ITGuyFromIA2/AxxSolder_hw/README.md

# AxxSolder_hw
Hardware repository for AxxSolder  
  
**Find the main AxxSolder repo here: [https://github.com/AxxAxx/AxxSolder](https://github.com/AxxAxx/AxxSolder)**
