ITGuyFromIA2/AxxSolder_hw/bom/BOM_AxxSolder_V2_2.xlsx

AxxSolder V2.2 | Prises as per 2023-10-03 |  | Parts for AxxSolder Station only
 |  |  | Parts for AxxSolder Poratble only
Part | Value | Device | Footprint | # in design | Price / component | Price / unit |  |  | Datasheet | Manufacturer_Part_Number | Mouser Part Number
C1, C6, C12, C14, C19 | 10u | Device:C_Small | Capacitor_SMD:C_0805_2012Metric | 5 | €0.32 | €1.60 | https://www.mouser.se/ProductDetail/Murata-Electronics/GRM21BR6YA106ME43L?qs=K0Sa7bCb58L8Cutg5cHuEA%3D%3D | https://www.mouser.com/ProductDetail/Murata-Electronics/GRM21BR6YA106ME43L?qs=K0Sa7bCb58L8Cutg5cHuEA%3D%3D | ~
C2, C3, C5, C7, C8, C9, C10, C11, C13, C20, C21, C22, C24, C28, C29 | 100n | Device:C_Small | Capacitor_SMD:C_0805_2012Metric | 15 | €0.09 | €1.40 | https://www.mouser.se/ProductDetail/KYOCERA-AVX/KGM21NR71H104KT?qs=Jm2GQyTW%2Fbj%252BykwLLGtT1A%3D%3D | https://www.mouser.com/ProductDetail/KYOCERA-AVX/KGM21NR71H104KT?qs=Jm2GQyTW%2Fbj%252BykwLLGtT1A%3D%3D | ~
C4, C25, C27 | 22u | Device:C_Small | Capacitor_SMD:C_1206_3216Metric | 3 | €0.54 | €1.62 | https://www.mouser.se/ProductDetail/TDK/C2012X6S1C226M125AC?qs=6JAMGB%252BEdkzwYUkuPLa%252B7A%3D%3D | https://www.mouser.com/ProductDetail/TDK/C2012X6S1C226M125AC?qs=6JAMGB%252BEdkzwYUkuPLa%252B7A%3D%3D
C17, C18 | 22u/35V | Device:C_Small | Capacitor_SMD:C_0805_2012Metric | 2 | €0.88 | €1.76 | https://www.mouser.se/ProductDetail/TDK/C3216X5R1V226M160AC?qs=NRhsANhppD8TwN31eZ1xGQ%3D%3D | https://www.mouser.com/ProductDetail/TDK/C3216X5R1V226M160AC?qs=NRhsANhppD8TwN31eZ1xGQ%3D%3D
C15, C16 | 1n | Device:C_Small | Capacitor_SMD:C_0805_2012Metric | 2 | €0.09 | €0.19 | https://www.mouser.se/ProductDetail/KYOCERA-AVX/KGM21NR71H102KT?qs=Jm2GQyTW%2FbjaB2aNl9uKTA%3D%3D | https://www.mouser.com/ProductDetail/KYOCERA-AVX/KGM21NR71H102KT?qs=Jm2GQyTW%2FbjaB2aNl9uKTA%3D%3D | ~
C23 | 330u | EMZR500ARA331MJA0G:EMZR500ARA331MJA0G | EMZR500ARA331MJA0G:CAPAE1030X1050N | 1 | €1.16 | €1.16 | https://www.mouser.se/ProductDetail/Chemi-Con/EMZR500ARA331MJA0G?qs=y6ZabgHbY%252ByH%252BUe1C3ntew%3D%3D | https://www.mouser.com/ProductDetail/Chemi-Con/EMZR500ARA331MJA0G?qs=y6ZabgHbY%252ByH%252BUe1C3ntew%3D%3D | https://ru.mouser.com/datasheet/2/420/United-Chemi-Con-776012.pdf | EMZR500ARA331MJA0G | 661-EMZR500ARA331MJA
C26 | 75p | Device:C_Small | Capacitor_SMD:C_0805_2012Metric | 1 | €0.15 | €0.15 | https://www.mouser.se/ProductDetail/KYOCERA-AVX/08051A750JAT2A?qs=xM%2FcMNU7BsFb8CFBKrIbNg%3D%3D | https://www.mouser.com/ProductDetail/KYOCERA-AVX/08051A750JAT2A?qs=xM%2FcMNU7BsFb8CFBKrIbNg%3D%3D |  | 08051A750JAT2A
D1, D3, D5, D6, D12 | BAT54S | Device:D_Schottky_Dual_Series_AKC | BAT54S,215:SOT95P230X110-3N | 5 | €0.26 | €1.30 | https://www.mouser.se/ProductDetail/Diotec-Semiconductor/BAT54S?qs=OlC7AqGiEDl5%2FwzZD7rGmQ%3D%3D | https://www.mouser.com/ProductDetail/Diotec-Semiconductor/BAT54S?qs=OlC7AqGiEDl5%2FwzZD7rGmQ%3D%3D | ~
D2 | PMEG6020ER | PMEG6020ER_115:PMEG6020ER,115 | PMEG6020ER,115:PMEG6020ER115 | 1 | €0.42 | €0.42 | https://www.mouser.se/ProductDetail/Nexperia/PMEG6020ER115?qs=5DYmZrWuUErk3dU9e9SSpA%3D%3D | https://www.mouser.com/ProductDetail/Nexperia/PMEG6020ER115?qs=5DYmZrWuUErk3dU9e9SSpA%3D%3D | https://assets.nexperia.com/documents/data-sheet/PMEG6020ER.pdf | PMEG6020ER,115 | 771-PMEG6020ER-115
D4 | Waveshare 1.5inch OLED Module | 1_5inch-rgb-oled-module_asm-1110:1_5inch-rgb-oled-module_asm-1110 | 1_5inch-rgb-oled-module_asm-1110:1_5inch-rgb-oled-module_asm-1110 | 1 | €12.90 | €12.90 | https://www.welectron.com/Waveshare-13992-15inch-OLED-Module_1 | https://www.welectron.com/Waveshare-13992-15inch-OLED-Module_1
D7 | PMEG10030ELPX | PMEG10030ELPX:PMEG10030ELPX | PMEG10030ELPX:SODFL4725X110N | 1 | €0.45 | €0.45 | https://www.mouser.se/ProductDetail/Nexperia/PMEG10030ELPX?qs=bel5lzaZNxQd6L7wuvMmFQ%3D%3D | https://www.mouser.com/ProductDetail/Nexperia/PMEG10030ELPX?qs=bel5lzaZNxQd6L7wuvMmFQ%3D%3D | https://assets.nexperia.com/documents/data-sheet/PMEG10030ELP.pdf | PMEG10030ELPX | 771-PMEG10030ELPX
D9 | SMBJ24CA | SMBJ24CA:SMBJ24CA | DIOM5436X261N | 1 | €0.34 | €0.34 | https://www.mouser.se/ProductDetail/Littelfuse/SMBJ24CA?qs=JJML70Qc14u3Wc4gmMep1w%3D%3D | https://www.mouser.com/ProductDetail/Littelfuse/SMBJ24CA?qs=JJML70Qc14u3Wc4gmMep1w%3D%3D | https://www.mouser.se/datasheet/2/240/media-3319099.pdf | SMBJ24CA | 576-SMBJ24CA
F1 | 10A Fuse | Device:Fuse | 3557-2:3557-2 | 1 | €1.10 | €1.10 | https://www.mouser.se/ProductDetail/Keystone-Electronics/3557-2?qs=cxy41lVAGV%2FfbyASjpXK1g%3D%3D | https://www.mouser.com/ProductDetail/Keystone-Electronics/3557-2?qs=cxy41lVAGV%2FfbyASjpXK1g%3D%3D | ~
IC1 | LTC4440AHMS8E-5#PBF | LTC4440AHMS8E-5#PBF:LTC4440AHMS8E-5#PBF | LTC4440AHMS8E-5#PBF:SOP65P490X110-9N | 1 | €5.72 | €5.72 | https://www.mouser.se/ProductDetail/Analog-Devices/LTC4440AHMS8E-5PBF?qs=hVkxg5c3xu86VC%252BBJjm7uA%3D%3D | https://www.mouser.com/ProductDetail/Analog-Devices/LTC4440AHMS8E-5PBF?qs=hVkxg5c3xu86VC%252BBJjm7uA%3D%3D | https://www.arrow.com/en/products/ltc4440ahms8e-5pbf/analog-devices | LTC4440AHMS8E-5#PBF | 584-C4440AHMS8E-5PBF
IC2 | STM32G431KBT6 | STM32G431KBT6:STM32G431KBT6 | STM32G431KBT6:QFP80P900X900X160-32N | 1 | €6.45 | €6.45 | https://www.mouser.se/ProductDetail/STMicroelectronics/STM32G431KBT6?qs=T3oQrply3y8teCTeNAFOLg%3D%3D | https://www.mouser.com/ProductDetail/STMicroelectronics/STM32G431KBT6?qs=T3oQrply3y8teCTeNAFOLg%3D%3D | https://www.st.com/resource/en/datasheet/stm32g431kb.pdf | STM32G431KBT6 | 511-STM32G431KBT6
L1 | SRP7028CC-100M | SRP7028CC-100M:SRP7028CC-100M | INDPM7366X300N | 1 | €0.75 | €0.75 | https://www.mouser.se/ProductDetail/Bourns/SRP7028CC-100M?qs=1Kr7Jg1SGW%252BFrchEKUd2WQ%3D%3D | https://www.mouser.com/ProductDetail/Bourns/SRP7028CC-100M?qs=1Kr7Jg1SGW%252BFrchEKUd2WQ%3D%3D | https://www.bourns.com/docs/Product-Datasheets/SRP7028CC.pdf | SRP7028CC-100M | 652-SRP7028CC-100M
IC3 | TMP236AQDBZRQ1 | TMP236AQDBZRQ1:TMP236AQDBZRQ1 | TMP236AQDBZRQ1:SOT95P237X112-3N | 1 | €0.55 | €0.55 | https://www.mouser.se/ProductDetail/Texas-Instruments/TMP236AQDBZRQ1?qs=T3oQrply3y83CHFf%2F7t6GQ%3D%3D | https://www.mouser.com/ProductDetail/Texas-Instruments/TMP236AQDBZRQ1?qs=T3oQrply3y83CHFf%2F7t6GQ%3D%3D | https://www.ti.com/lit/gpn/TMP236-Q1 | TMP236AQDBZRQ1 | 595-TMP236AQDBZRQ1
IC4 | OPA2333AIDRBR | OPA2333AIDRBR:OPA2333AIDRBR | OPA2333AIDRBR:SON65P300X300X100-9N-D | 1 | €3.78 | €3.78 | https://www.mouser.se/ProductDetail/Texas-Instruments/OPA2333AIDRBR?qs=pJP364FAHqRpZMi9vrj2VQ%3D%3D | https://www.mouser.com/ProductDetail/Texas-Instruments/OPA2333AIDRBR?qs=pJP364FAHqRpZMi9vrj2VQ%3D%3D | https://www.ti.com/lit/ds/symlink/opa2333.pdf?ts=1606982025063 | OPA2333AIDRBR | 595-OPA2333AIDRBR
J1 | Conn_01x07_Male | Connector:Conn_01x07_Male | 691243310007:691243310007 | 1 | €2.99 | €2.99 | https://www.mouser.se/ProductDetail/Wurth-Elektronik/691243310007?qs=sPbYRqrBIVlY9pfFip%2Fg9g%3D%3D | https://www.mouser.com/ProductDetail/Wurth-Elektronik/691243310007?qs=sPbYRqrBIVlY9pfFip%2Fg9g%3D%3D | ~
J4 | Conn_01x07_Male | Connector:Conn_01x07_Male | Connector_PinSocket_2.54mm:PinSocket_1x07_P2.54mm_Vertical | 1 | €1.50 | €1.50 | https://www.mouser.se/ProductDetail/TE-Connectivity/5-534237-5?qs=GYgf5PdsjzmjeTI%2Fz24JQA%3D%3D | https://www.mouser.com/ProductDetail/TE-Connectivity/5-534237-5?qs=GYgf5PdsjzmjeTI%2Fz24JQA%3D%3D | ~
LS1 | CMI-9653S-SMT-TR | CMI-9653S-SMT-TR:CMI-9653S-SMT-TR | CMI-9653S-SMT-TR:CMI9653SSMTTR | 1 | €2.71 | €2.71 | https://www.mouser.se/ProductDetail/CUI-Devices/CMI-9653S-SMT-TR?qs=qCxwlXJ4fnz7UpLQu8UKbg%3D%3D | https://www.mouser.com/ProductDetail/CUI-Devices/CMI-9653S-SMT-TR?qs=qCxwlXJ4fnz7UpLQu8UKbg%3D%3D | https://componentsearchengine.com/Datasheets/1/CMI-9653S-SMT-TR.pdf | CMI-9653S-SMT-TR | 490-CMI-9653S-SMT-TR
PS1 | LD1117AS33TR | LD1117AS33TR:LD1117AS33TR | SOT230P700X190-4N | 1 | €0.84 | €0.84 | https://www.mouser.se/ProductDetail/STMicroelectronics/LD1117AS33TR?qs=C3bf%2FVrkE5CoDDd7wyn%252BaQ%3D%3D | https://www.mouser.com/ProductDetail/STMicroelectronics/LD1117AS33TR?qs=C3bf%2FVrkE5CoDDd7wyn%252BaQ%3D%3D | https://4donline.ihs.com/images/VipMasterIC/IC/SGST/SGSTS49356/SGSTS49356-1.pdf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 | LD1117AS33TR | 511-LD1117AS33
IC6 | TPS54302DDCR | TPS54302DDCR:TPS54302DDCR | SOT95P280X110-6N | 1 | €1.84 | €1.84 | https://www.mouser.se/ProductDetail/Texas-Instruments/TPS54302DDCT?qs=zEmsApcVOkXGTx6CMk2KtQ%3D%3D | https://www.mouser.com/ProductDetail/Texas-Instruments/TPS54302DDCT?qs=zEmsApcVOkXGTx6CMk2KtQ%3D%3D | https://www.ti.com/general/docs/suppproductinfo.tsp?distId=26&gotoUrl=https://www.ti.com/lit/gpn/tps54302 | TPS54302DDCT
Q2 | 2N7002NXAKR | 2N7002NXAKR:2N7002NXAKR | 2N7002NXAKR:SOT95P230X110-3N | 1 | €0.18 | €0.18 | https://www.mouser.se/ProductDetail/Nexperia/2N7002NXAKR?qs=%252B6g0mu59x7JoAsZYPFXqhw%3D%3D | https://www.mouser.com/ProductDetail/Nexperia/2N7002NXAKR?qs=%252B6g0mu59x7JoAsZYPFXqhw%3D%3D | https://assets.nexperia.com/documents/data-sheet/2N7002NXAK.pdf | 2N7002NXAKR | 771-2N7002NXAKR
R1, R5, R6, R17, R25, R26 | 4k7 | Device:R_Small | Resistor_SMD:R_0805_2012Metric | 6 | €0.36 | €2.18 | https://www.mouser.se/ProductDetail/Panasonic/ERJ-HP6D4701V?qs=eP2BKZSCXI5V1EkyCWJmgQ%3D%3D | https://www.mouser.com/ProductDetail/Panasonic/ERJ-HP6D4701V?qs=eP2BKZSCXI5V1EkyCWJmgQ%3D%3D | ~
R2 | 47k | Device:R_Small | Resistor_SMD:R_0805_2012Metric | 1 | €0.19 | €0.19 | https://www.mouser.se/ProductDetail/Panasonic/ERJ-P06F4702V?qs=iIVTEDlrHA3GchgRrCB%252BPw%3D%3D | https://www.mouser.com/ProductDetail/Panasonic/ERJ-P06F4702V?qs=iIVTEDlrHA3GchgRrCB%252BPw%3D%3D | ~
R3 | 6k8 | Device:R_Small | Resistor_SMD:R_0805_2012Metric | 1 | €0.27 | €0.27 | https://www.mouser.se/ProductDetail/ROHM-Semiconductor/SDR10EZPF6801?qs=ulEaXIWI0c%252B7C%252BEu89Fpsg%3D%3D | https://www.mouser.com/ProductDetail/ROHM-Semiconductor/SDR10EZPF6801?qs=ulEaXIWI0c%252B7C%252BEu89Fpsg%3D%3D | ~
R8, R9, R11, R12, R13, R14, R16, R18 | 10k | Device:R_Small | Resistor_SMD:R_0805_2012Metric | 8 | €0.17 | €1.34 | https://www.mouser.se/ProductDetail/Panasonic/ERJ-P06F1002V?qs=Zyl8A9hlmJpSDn8Y2yUh3g%3D%3D | https://www.mouser.com/ProductDetail/Panasonic/ERJ-P06F1002V?qs=Zyl8A9hlmJpSDn8Y2yUh3g%3D%3D | ~
R10 | 2m | Device:R_Small | WSLP25122L500FEA:RESC6432X89N | 1 | €0.92 | €0.92 | https://www.mouser.se/ProductDetail/Vishay-Dale/WSLP25122L500FEA?qs=%2FCXICPRLKg%252BpcyljWM%2FHhA%3D%3D | https://www.mouser.com/ProductDetail/Vishay-Dale/WSLP25122L500FEA?qs=%2FCXICPRLKg%252BpcyljWM%2FHhA%3D%3D | ~
R15 | 220 | Device:R_Small | Resistor_SMD:R_0805_2012Metric | 1 | €0.16 | €0.16 | https://www.mouser.se/ProductDetail/Panasonic/ERJ-P06F2200V?qs=iIVTEDlrHA386ZSEyaXM2A%3D%3D | https://www.mouser.com/ProductDetail/Panasonic/ERJ-P06F2200V?qs=iIVTEDlrHA386ZSEyaXM2A%3D%3D | ~
R19, R20 | 1k5 | Device:R_Small | Resistor_SMD:R_0805_2012Metric | 2 | €0.18 | €0.35 | https://www.mouser.se/ProductDetail/Panasonic/ERJ-T06J152V?qs=iIVTEDlrHA26dD1FOa2exQ%3D%3D | https://www.mouser.com/ProductDetail/Panasonic/ERJ-T06J152V?qs=iIVTEDlrHA26dD1FOa2exQ%3D%3D | ~
R21, R22 | 470k | Device:R_Small | Resistor_SMD:R_0805_2012Metric | 2 | €0.09 | €0.19 | https://www.mouser.se/ProductDetail/Panasonic/ERJ-6ENF4703V?qs=JjxTDIFmKPR1WT6%252Bqzbe%2FA%3D%3D | https://www.mouser.com/ProductDetail/Panasonic/ERJ-6ENF4703V?qs=JjxTDIFmKPR1WT6%252Bqzbe%2FA%3D%3D | ~
R23, R24 | 220k | Device:R_Small | Resistor_SMD:R_0805_2012Metric | 2 | €0.09 | €0.19 | https://www.mouser.se/ProductDetail/Panasonic/ERJ-6ENF2203V?qs=50QC8w71jAuUzUf5ycREdA%3D%3D | https://www.mouser.com/ProductDetail/Panasonic/ERJ-6ENF2203V?qs=50QC8w71jAuUzUf5ycREdA%3D%3D | ~
R27 | 49.9 | Device:R_Small | Resistor_SMD:R_0805_2012Metric | 1 | €0.16 | €0.16 | https://www.mouser.se/ProductDetail/Vishay-Dale/RCC080549R9FKEA?qs=GedFDFLaBXFSdbXYm9WSig%3D%3D | https://www.mouser.com/ProductDetail/Vishay-Dale/RCC080549R9FKEA?qs=GedFDFLaBXFSdbXYm9WSig%3D%3D
R28 | 100k | Device:R_Small | Resistor_SMD:R_0805_2012Metric | 1 | €0.09 | €0.09 | https://www.mouser.se/ProductDetail/Bourns/CR0805AFX-1003ELF?qs=GedFDFLaBXEQCAFxmzLWkA%3D%3D | https://www.mouser.com/ProductDetail/Bourns/CR0805AFX-1003ELF?qs=GedFDFLaBXEQCAFxmzLWkA%3D%3D
R29 | 13k3 | Device:R_Small | Resistor_SMD:R_0805_2012Metric | 1 | €0.09 | €0.09 | https://www.mouser.se/ProductDetail/Bourns/CR0805-FX-1332ELF?qs=Hqdsf0hGw%2FBPaTV9GpndaQ%3D%3D | https://www.mouser.com/ProductDetail/Bourns/CR0805-FX-1332ELF?qs=Hqdsf0hGw%2FBPaTV9GpndaQ%3D%3D
U1 | PEC11L-4220F-S0015 | PEC11L-4220F-S0015:PEC11L-4220F-S0015 | PEC11L4220FS0015 | 1 | €2.07 | €2.07 | https://www.mouser.se/ProductDetail/Bourns/PEC11L-4220F-S0015?qs=Q4nXA9D1WFOSxqK3IduBbA%3D%3D | https://www.mouser.com/ProductDetail/Bourns/PEC11L-4220F-S0015?qs=Q4nXA9D1WFOSxqK3IduBbA%3D%3D | https://www.bourns.com/PDFs/pec11l.pdf | PEC11L-4220F-S0015 | 652-PEC11L4220FS0015
U2 | BSC014N04LS | BSC014N04LS:BSC014N04LS | BSC014N04LS:BSC014N04LS | 1 | €1.60 | €1.60 | https://www.mouser.se/ProductDetail/Infineon-Technologies/BSC014N04LS?qs=EUA%2Fg8wssK2F8IHptsBUDw%3D%3D | https://www.mouser.com/ProductDetail/Infineon-Technologies/BSC014N04LS?qs=EUA%2Fg8wssK2F8IHptsBUDw%3D%3D
SUM Components |  |  |  |  |  | €61.47
Hardware
PCB |  |  |  | 1 | €2.00 | €2.00 | N/A
Fuse 10A |  |  |  | 1 | €0.38 | €0.38 | https://www.mouser.se/ProductDetail/Littelfuse/0891005.NXS?qs=5b8eIUDTslk98GtnISs9VA%3D%3D
Connector for JBC stand (binder 99-0624-00-07) |  |  |  | 1 | €5.11 | €5.11 | https://de.farnell.com/binder/99-0624-00-07/socket-panelmontage-7pol/dp/1122418?pf_custSiteRedirect=true
Connector for soldering iron (HIROSE(HRS) RPC1-12RB-6P(71)) |  |  |  | 1 | €6.11 | €6.11 | https://de.farnell.com/hirose-hrs/rpc1-12rb-6p-71/rundstecker-panelmontage-6pol/dp/1077728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
Power connector (Anderson PP30)BLACK |  |  |  | 2 | €1.22 | €2.44 | https://www.mouser.se/ProductDetail/Anderson-Power-Products/1330G4?qs=yoCgdRjoRtEz6n6mDpzjEQ%3D%3D
Power connector (Anderson PP30) RED |  |  |  | 2 | €1.22 | €2.44 | https://www.mouser.se/ProductDetail/Anderson-Power-Products/1330?qs=yoCgdRjoRtExZTZ%2Fg8W40Q%3D%3D
Rotary encoder knob |  |  |  | 1 | €2.01 | €2.01 | https://www.mouser.se/ProductDetail/Davies-Molding/1109?qs=byeeYqUIh0OoGHtJMXf6Uw%3D%3D
Rocker Switch (R13-66A-02-BB2) |  |  |  | 1 | €2.47 | €2.47 | https://www.mouser.se/ProductDetail/Shin-Chin/R13-66A-02-BB2?qs=m3yEn%2FjtVGBWcDYFMFAvxw%3D%3D
3D printed housing |  |  |  | 1 | €5.00 | €5.00 | N/A
Screws - M3x8mm countersunk | For the display |  |  | 4 | €0.10 | €0.40 | N/A
Screws - M4x8mm | For enclosure to JBS stand |  |  | 1 | €0.20 | €0.40 | N/A
Screws - M2.5x10mm | For the binder 99-0624-00-07 |  |  | 4 | €0.10 | €0.40 | N/A
Screws - M2x8mm + nuts | For the aluminium rest |  |  | 2 | €0.10 | €0.20 | N/A
Aluminium plate 15x10x3 mm |  |  |  | 1 | €1.00 | €1.00 | N/A
SUM Hardware |  |  |  |  |  | €30.36
JBC stand
JBS Stand |  |  |  | 1 | €171.40 | 171.4 | https://www.tme.eu/se/en/details/jbc-ad-sf/soldering-iron-stands-feeders/jbc-tools/ad-sf/ (https://www.aliexpress.com/item/1005005736571669.html)
Non-genuine Stand |  | WARNING: NOT tested! Use at own risk
Non-brand Stand |  |  |  | 1 | €35.06 | 35.06 | https://www.aliexpress.com/item/1005005857983522.html
JBC T210 handle piece
T210 handle piece |  |  |  | 1 | €66.34 | 66.34 | https://www.tme.eu/se/en/details/jbc-t210-a/soldering-stations-accessories/jbc-tools/t210-a/
c210-0008 tip |  |  |  | 1 | €38.34 | 38.34 | https://www.tme.eu/se/en/details/jbc-c210008/soldering-tips/jbc-tools/c210008/
SUM JBC stand and handle |  |  |  |  |  | €104.68
TOTAL Sum with genuine JBC handle and stand |  |  |  |  |  | €367.91
TOTAL Sum with non-genuine JBC stand |  |  |  |  |  | €231.57
