ITGuyFromIA2/AxxSolder_hw/AxxSolder.kicad_pcb

## KiCad design AxxSolder.kicad_pcb (2023-10-18)

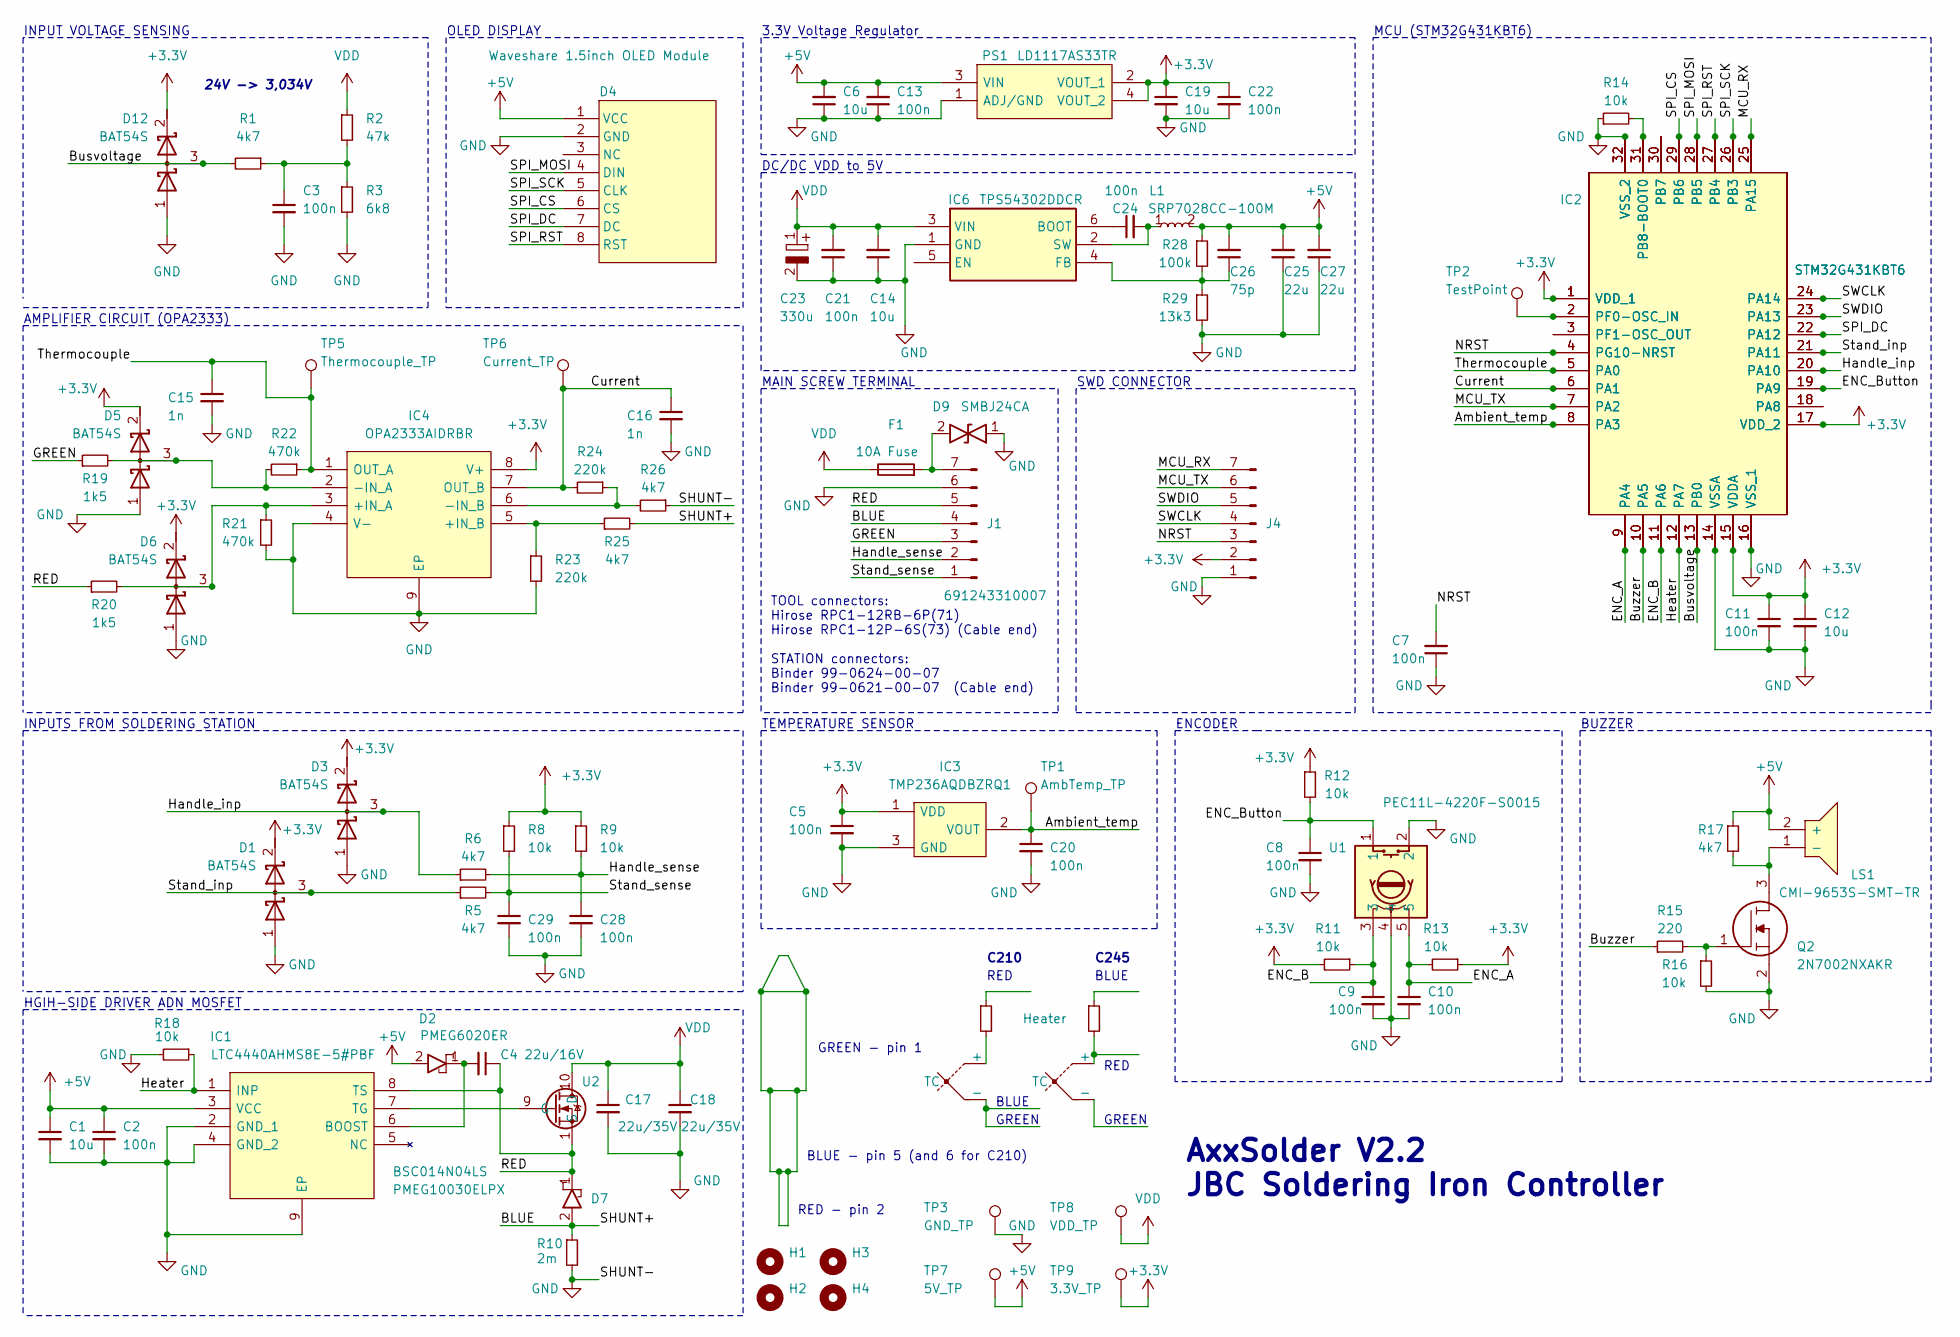
[picture p1: schematic AxxSolder.kicad_sch]

Parts:
C1, C6, C12, C14, C19: 10u; C_0805_2012Metric
C2, C3, C5, C7, C8, C9, C10, C11, C13, C20, C21, C22, C24, C28, C29: 100n; C_0805_2012Metric
C4: 22u/16V; C_1206_3216Metric
C15, C16: 1n; C_0805_2012Metric
C17, C18: 22u/35V; C_1206_3216Metric
C23: 330u; CAPAE1030X1050N; Mouser Part Number 661-EMZR500ARA331MJA
C25, C27: 22u; C_1206_3216Metric
C26: 75p; C_0805_2012Metric
D1, D3, D5, D6, D12: BAT54S; SOT95P230X110-3N
D2: PMEG6020ER; PMEG6020ER115; Mouser Part Number 771-PMEG6020ER-115
D4: Waveshare 1.5inch OLED Module; 1_5inch-rgb-oled-module_asm-1110
D7: PMEG10030ELPX; SODFL4725X110N; Mouser Part Number 771-PMEG10030ELPX
D9: SMBJ24CA; DIOM5436X261N; Mouser Part Number 576-SMBJ24CA
F1: 10A Fuse; 3557-2
H1, H2, H3, H4: MountingHole; MountingHole_3mm
IC1: LTC4440AHMS8E-5#PBF; SOP65P490X110-9N; Mouser Part Number 584-C4440AHMS8E-5PBF
IC2: STM32G431KBT6; QFP80P900X900X160-32N; Mouser Part Number 511-STM32G431KBT6
IC3: TMP236AQDBZRQ1; SOT95P237X112-3N; Mouser Part Number 595-TMP236AQDBZRQ1
IC4: OPA2333AIDRBR; SON65P300X300X100-9N-D; Mouser Part Number 595-OPA2333AIDRBR
IC5: STM32G431KBT6; UFQFPN-32-1EP_5x5mm_P0.5mm_EP3.5x3.5mm; Mouser Part Number 511-STM32G431KBT6
IC6: TPS54302DDCR; SOT95P280X110-6N; Mouser Part Number 595-TPS54302DDCR
J1: Conn_01x07_Male; 691243310007; Manufacturer_Part_Number 691243310007
J4: Conn_01x07_Male; PinSocket_1x07_P2.54mm_Vertical
L1: SRP7028CC-100M; INDPM7366X300N; Manufacturer_Part_Number SRP7028CC-100M
LS1: CMI-9653S-SMT-TR; CMI9653SSMTTR; Mouser Part Number 490-CMI-9653S-SMT-TR
PS1: LD1117AS33TR; SOT230P700X190-4N; Mouser Part Number 511-LD1117AS33
Q2: 2N7002NXAKR; SOT95P230X110-3N; Manufacturer_Part_Number 2N7002NXAKR; Mouser Part Number 771-2N7002NXAKR
R1, R5, R6, R17, R25, R26: 4k7; R_0805_2012Metric
R2: 47k; R_0805_2012Metric
R3: 6k8; R_0805_2012Metric
R4: Heater
R7: Heater 2 OHM
R8, R9, R11, R12, R13, R14, R16, R18: 10k; R_0805_2012Metric
R10: 2m; RESC6432X89N; part_id WSLP25122L500FEA
R15: 220; R_0805_2012Metric
R19, R20: 1k5; R_0805_2012Metric
R21, R22: 470k; R_0805_2012Metric
R23, R24: 220k; R_0805_2012Metric
R28: 100k; R_0805_2012Metric
R29: 13k3; R_0805_2012Metric
TC1, TC2: TC
TP1: AmbTemp_TP; TestPoint_THTPad_D1.0mm_Drill0.5mm
TP2: TestPoint; TestPoint_Pad_D1.0mm
TP3: GND_TP; TestPoint_THTPad_D1.0mm_Drill0.5mm
TP5: Thermocouple_TP; TestPoint_Pad_D1.0mm
TP6: Current_TP; TestPoint_Pad_D1.0mm
TP7: 5V_TP; TestPoint_THTPad_D1.0mm_Drill0.5mm
TP8: VDD_TP; TestPoint_THTPad_D1.0mm_Drill0.5mm
TP9: 3.3V_TP; TestPoint_THTPad_D1.0mm_Drill0.5mm
U1: PEC11L-4220F-S0015; PEC11L4220FS0015; Mouser Part Number 652-PEC11L4220FS0015
U2: BSC014N04LS

Connections:
+3.3V: C5.1, C11.1, C12.1, C19.1, C22.1, D1.2 (K), D3.2 (K), D5.2 (K), D6.2 (K), D12.2 (K), IC2.1 (VDD_1), IC2.15 (VDDA), IC2.17 (VDD_2), IC3.1 (VDD), IC4.8 (V+), IC5.1 (VDD_1), IC5.15 (VDDA), IC5.17 (VDD_2), J4.2, PS1.2 (VOUT_1), PS1.4 (VOUT_2), R8.1, R9.1, R11.2, R12.1, R13.1, TP9.1
+5V: C1.1, C2.1, C6.2, C13.2, C25.2, C26.2, C27.2, D2.2, D4.1 (VCC), IC1.3 (VCC), L1.2, LS1.2 (+), PS1.3 (VIN), R17.1, R28.1, TP7.1
/Ambient_temp: C20.1, IC2.8 (PA3), IC3.2 (VOUT), IC5.8 (PA3), TP1.1
/BLUE: D7.2, J1.4, R10.1, R25.2
/Busvoltage: D12.3 (common), IC2.13 (PB0), IC5.13 (PB0), R1.2
/Buzzer: IC2.10 (PA5), IC5.10 (PA5), R15.1
/Current: C16.1, IC2.6 (PA1), IC4.7 (OUT_B), IC5.6 (PA1), R24.2, TP6.1
/ENC_A: C10.1, IC2.9 (PA4), IC5.9 (PA4), R13.2, U1.5
/ENC_B: C9.1, IC2.11 (PA6), IC5.11 (PA6), R11.1, U1.3
/ENC_Button: C8.1, IC2.19 (PA9), IC5.19 (PA9), R12.2, U1.1
/GREEN: J1.3, R19.1
/Handle_inp: D3.3 (common), IC2.20 (PA10), IC5.20 (PA10), R6.1
/Handle_sense: C28.1, J1.2, R6.2, R9.2
/Heater: IC1.1 (INP), IC2.12 (PA7), IC5.12 (PA7), R18.1
/MCU_RX: IC2.25 (PA15), IC5.25 (PA15), J4.7
/MCU_TX: IC2.7 (PA2), IC5.7 (PA2), J4.6
/NRST: C7.2, IC2.4 (PG10-NRST), IC5.4 (PG10-NRST), J4.3
/RED: C4.1, D7.1, IC1.8 (TS), J1.5, R20.1, U2.1 (S)
/SPI_CS: D4.6 (CS), IC2.29 (PB6), IC5.29 (PB6)
/SPI_DC: D4.7 (DC), IC2.22 (PA12), IC5.22 (PA12)
/SPI_MOSI: D4.4 (DIN), IC2.28 (PB5), IC5.28 (PB5)
/SPI_RST: D4.8 (RST), IC2.27 (PB4), IC5.27 (PB4)
/SPI_SCK: D4.5 (CLK), IC2.26 (PB3), IC5.26 (PB3)
/SWCLK: IC2.24 (PA14), IC5.24 (PA14), J4.4
/SWDIO: IC2.23 (PA13), IC5.23 (PA13), J4.5
/Stand_inp: D1.3 (common), IC2.21 (PA11), IC5.21 (PA11), R5.1
/Stand_sense: C29.1, J1.1, R5.2, R8.2
/Thermocouple: C15.1, IC2.5 (PA0), IC4.1 (OUT_A), IC5.5 (PA0), R22.1, TP5.1
GND: C1.2, C2.2, C3.2, C5.2, C6.1, C7.1, C8.2, C9.2, C10.2, C11.2, C12.2, C13.1, C14.1, C15.2, C16.2, C17.2, C18.2, C19.2, C20.2, C21.1, C22.2, C23.2, C25.1, C27.1, C28.2, C29.2, D1.1 (A), D3.1 (A), D4.2 (GND), D5.1 (A), D6.1 (A), D9.1, D12.1 (A), IC1.2 (GND_1), IC1.4 (GND_2), IC1.9 (EP), IC2.14 (VSSA), IC2.16 (VSS_1), IC2.32 (VSS_2), IC3.3 (GND), IC4.4 (V-), IC4.9 (EP), IC5.14 (VSSA), IC5.16 (VSS_1), IC5.32 (VSS_2), IC6.1 (GND), J1.6, J4.1, PS1.1 (ADJ/GND), Q2.2, R3.2, R10.2, R14.1, R16.2, R18.2, R21.2, R23.2, R26.1, R29.2, TP3.1, U1.2, U1.4
unnamed: C3.1, R1.1, R2.2, R3.1
unnamed: D5.3 (common), IC4.2 (-IN_A), R19.2, R22.2
unnamed: D6.3 (common), IC4.3 (+IN_A), R20.2, R21.1
unnamed: C4.2, D2.1, IC1.6 (BOOST)
unnamed: IC1.7 (TG), U2.9 (G)
unnamed: IC2.18 (PA8), IC5.18 (PA8)
unnamed: IC2.30 (PB7), IC5.30 (PB7)
unnamed: IC2.31 (PB8-BOOT0), IC5.31 (PB8-BOOT0), R14.2
unnamed: IC2.2 (PF0-OSC_IN), IC5.2 (PF0-OSC_IN), TP2.1
unnamed: IC2.3 (PF1-OSC_OUT), IC5.3 (PF1-OSC_OUT)
unnamed: IC4.5 (+IN_B), R23.1, R25.1
unnamed: IC4.6 (-IN_B), R24.1, R26.2
unnamed: C24.1, IC6.6 (BOOT)
unnamed: C26.1, IC6.4 (FB), R28.2, R29.1
unnamed: C24.2, IC6.2 (SW), L1.1
unnamed: D9.2, F1.2, J1.7
unnamed: LS1.1 (-), Q2.3, R17.2
unnamed: Q2.1, R15.2, R16.1
unnamed: R4.2, TC1.1 (+)
unnamed: R7.2, TC2.1 (+)
VDD: C14.2, C17.1, C18.1, C21.2, C23.1, F1.1, IC6.3 (VIN), R2.1, TP8.1, U2.10 (D)

Notes on the sheet:
C210
TEMPERATURE SENSOR
MCU (STM32G431KBT6)
C245
GREEN - pin 1
MAIN SCREW TERMINAL
AMPLIFIER CIRCUIT (OPA2333)
24V -> 3,034V
INPUT VOLTAGE SENSING
ENCODER
SWD CONNECTOR
BLUE
BLUE - pin 5 (and 6 for C210)
GREEN
RED
BUZZER
DC/DC VDD to 5V
AxxSolder V2.2 JBC Soldering Iron Controller
TOOL connectors: Hirose RPC1-12RB-6P(71) Hirose RPC1-12P-6S(73) (Cable end) STATION connectors: Binder 99-0624-00-07 Binder 99-0621-00-07 (Cable end)
INPUTS FROM SOLDERING STATION
HGIH-SIDE DRIVER ADN MOSFET
RED - pin 2
RED
3.3V Voltage Regulator
OLED DISPLAY

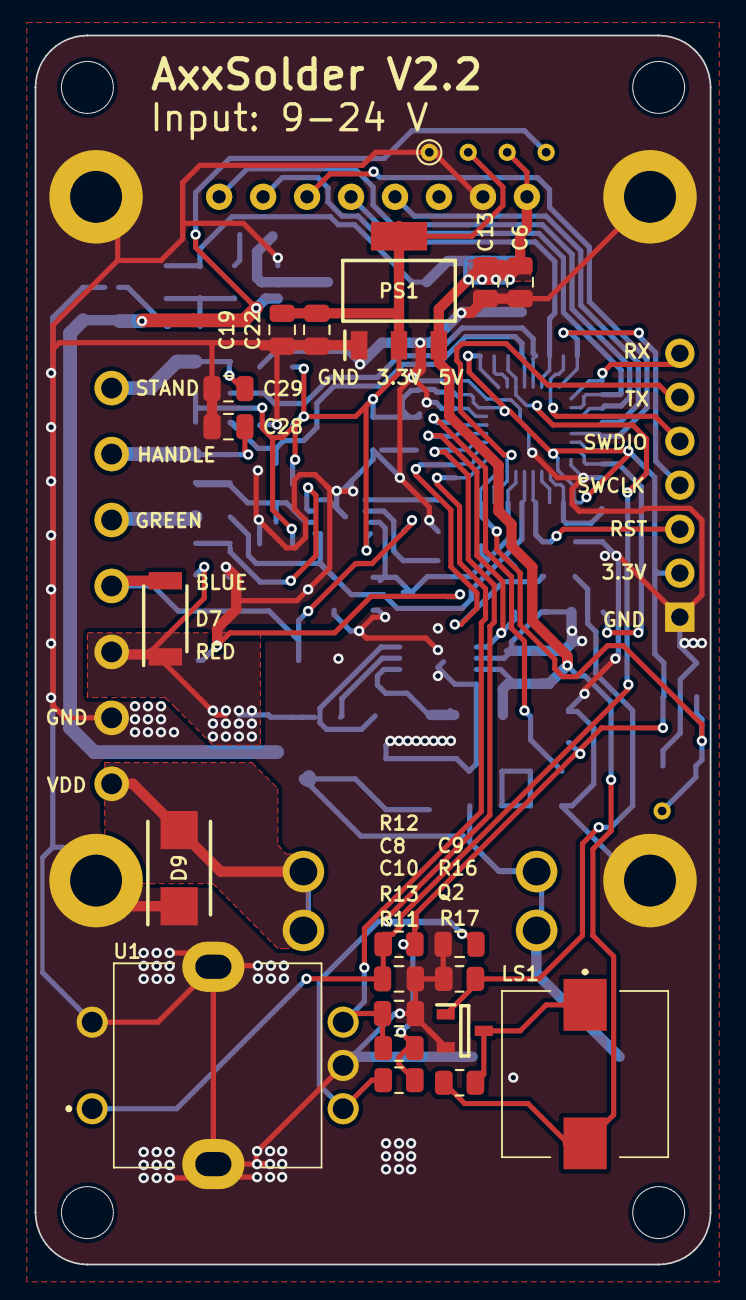
[picture p2: board AxxSolder.kicad_pcb from above]

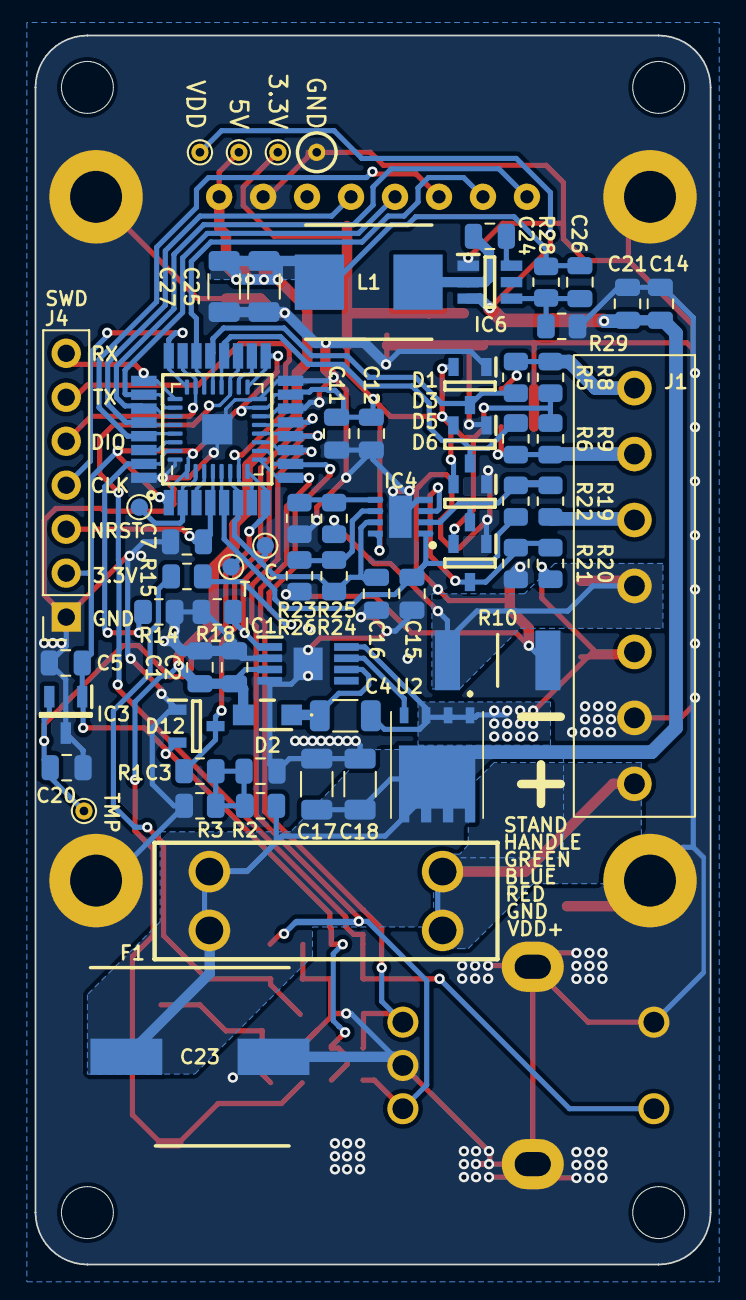
[picture p3: board AxxSolder.kicad_pcb from below]

Board: 2 copper layers, 39.0 x 71.0 mm, 91 parts (66 on the bottom side), 48 nets.
