ITGuyFromIA2/AxxSolder_hw/(commit log)

2023-09-12 Add "KiCad.gitignore"
2023-10-03 Add AxxSolder V2.0 BOM with cost
    [BOM_AxxSolder_V2_0.xlsx]
2023-10-03 update BOM_AxxSolder_V2_0-xlsx with cleaner links
    [BOM_AxxSolder_V2_0.xlsx]
2023-10-06 Change to new, more cost effective VCC->5V DC/DC solution, update to AxxSolder V2.1
    [AxxSolder-B_Cu.gbr, AxxSolder-B_Mask.gbr, AxxSolder-B_Paste.gbr, AxxSolder-B_Silkscreen.gbr, AxxSolder-Edge_Cuts.gbr, AxxSolder-F_Cu.gbr, AxxSolder-F_Mask.gbr, AxxSolder-F_Paste.gbr]
2023-10-06 Clean and structure schematic and update to AxxSolder V2.1
    [AxxSolder.kicad_sch]
2023-10-06 Clean and structure PCB Layout and update to AxxSolder V2.1
    [AxxSolder.kicad_pcb, AxxSolder.kicad_sch]
2023-10-07 Change silkscreen to Input: 9-24V and optimize board layout
    [AxxSolder-B_Cu.gbr, AxxSolder-B_Mask.gbr, AxxSolder-B_Paste.gbr, AxxSolder-B_Silkscreen.gbr, AxxSolder-Edge_Cuts.gbr, AxxSolder-F_Cu.gbr, AxxSolder-F_Mask.gbr, AxxSolder-F_Paste.gbr]
2023-10-07 Update PCB_3D.jpg with new version
2023-10-08 Update schematic to reflect new naming of inputs, Stand_inp and Handle_inp
    [AxxSolder.kicad_sch]
2023-10-09 Add screws and fuse to BOM
    [BOM_AxxSolder_V2_1.xlsx]
2023-10-09 Update schematic with proper connections
    [AxxSolder.kicad_sch]
2023-10-10 Add files with ending with # to KiCad.gitignore
2023-10-10 Change capacitor to higher voltage rating
    [BOM_AxxSolder_V2_1.xlsx]
2023-10-10 Update connectors in BOM
    [BOM_AxxSolder_V2_1.xlsx]
2023-10-10 update interactive BOM
2023-10-14 Fix output voltage from DC/DC by switching values of R28 and R27. Also change value of C24
    [AxxSolder.kicad_pcb, AxxSolder.kicad_sch, BOM_AxxSolder_V2_1.xlsx]
2023-10-15 Improve PCB layout slightly and update gerbers with cu-filled GND layer
    [AxxSolder-B_Cu.gbr, AxxSolder-B_Mask.gbr, AxxSolder-B_Paste.gbr, AxxSolder-B_Silkscreen.gbr, AxxSolder-Edge_Cuts.gbr, AxxSolder-F_Cu.gbr, AxxSolder-F_Mask.gbr, AxxSolder-F_Paste.gbr]
2023-10-16 Update BOM with C25 to be a 0805 Capacitor
    [BOM_AxxSolder_V2_1.xlsx]
2023-10-18 Update PCB design to V2.2 - correct fault in 5V DC/DC and change the VDD tVS diode to a 600W instead of 1.5kW and small PCB improvements
    [AxxSolder-B_Cu.gbr, AxxSolder-B_Mask.gbr, AxxSolder-B_Paste.gbr, AxxSolder-B_Silkscreen.gbr, AxxSolder-Edge_Cuts.gbr, AxxSolder-F_Cu.gbr, AxxSolder-F_Mask.gbr, AxxSolder-F_Paste.gbr]
2023-10-18 Update BOM
    [BOM_AxxSolder_V2_1.xlsx, BOM_AxxSolder_V2_2.xlsx]
2023-10-21 Update schematic to have show correct intenrnal connestions of JBC cartridges according to https://www.eevblog.com/forum/projects/axxsolder-jbc-soldering-controller/msg5124267/#msg5124267
    [AxxSolder.kicad_sch]
2023-11-19 remove PCB from main repository
    [AxxSolder-B_Cu.gbr, AxxSolder-B_Mask.gbr, AxxSolder-B_Paste.gbr, AxxSolder-B_Silkscreen.gbr, AxxSolder-Edge_Cuts.gbr, AxxSolder-F_Cu.gbr, AxxSolder-F_Mask.gbr, AxxSolder-F_Paste.gbr]
2023-11-19 Revert "remove PCB from main repository"
    This reverts commit 601f9d739a9a2e6bb7cbf2039fa2e6ec6f202c83.
    [AxxSolder-B_Cu.gbr, AxxSolder-B_Mask.gbr, AxxSolder-B_Paste.gbr, AxxSolder-B_Silkscreen.gbr, AxxSolder-Edge_Cuts.gbr, AxxSolder-F_Cu.gbr, AxxSolder-F_Mask.gbr, AxxSolder-F_Paste.gbr]
